wiebel/CANNode/Hardware/kicad/images/CANNode_rev2.0.jpg

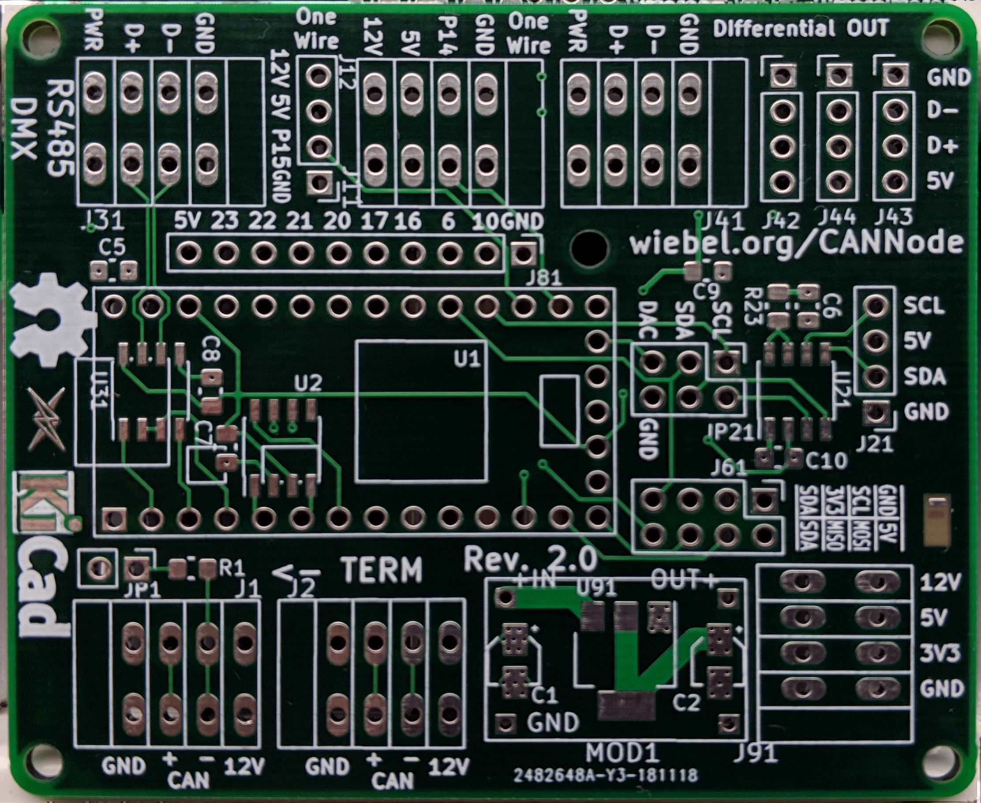
Hardware/kicad/images/CANNode_rev2.0.jpg
