wiebel/CANNode/Hardware/kicad/images/CANNode_rev2.5_top.png

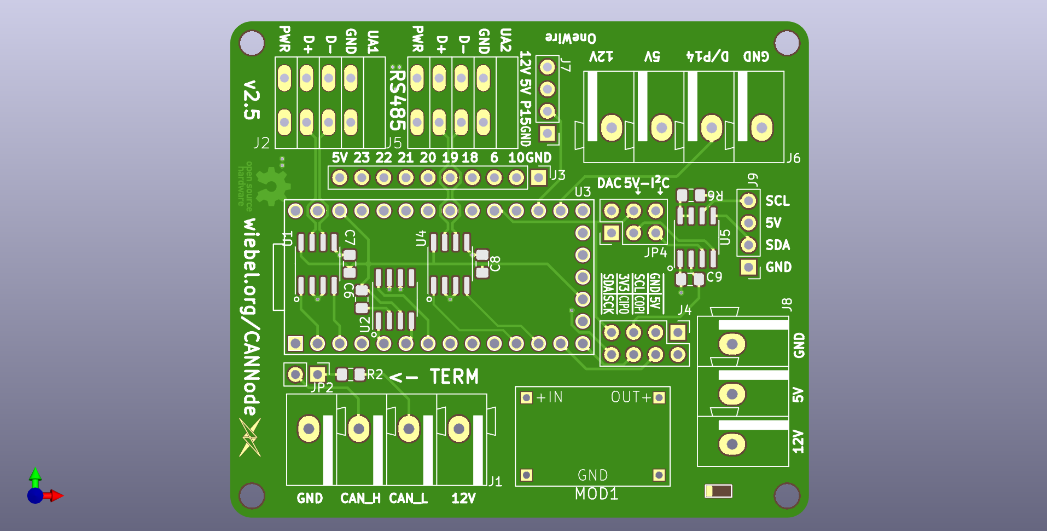
Hardware/kicad/images/CANNode_rev2.5_top.png
