wiebel/CANNode/README.md

Homegrown CAN/OW based home automation.

https://wiebel.org/CANNode/
