wiebel/CANNode/Hardware/eagle/CANNode_bottom.png

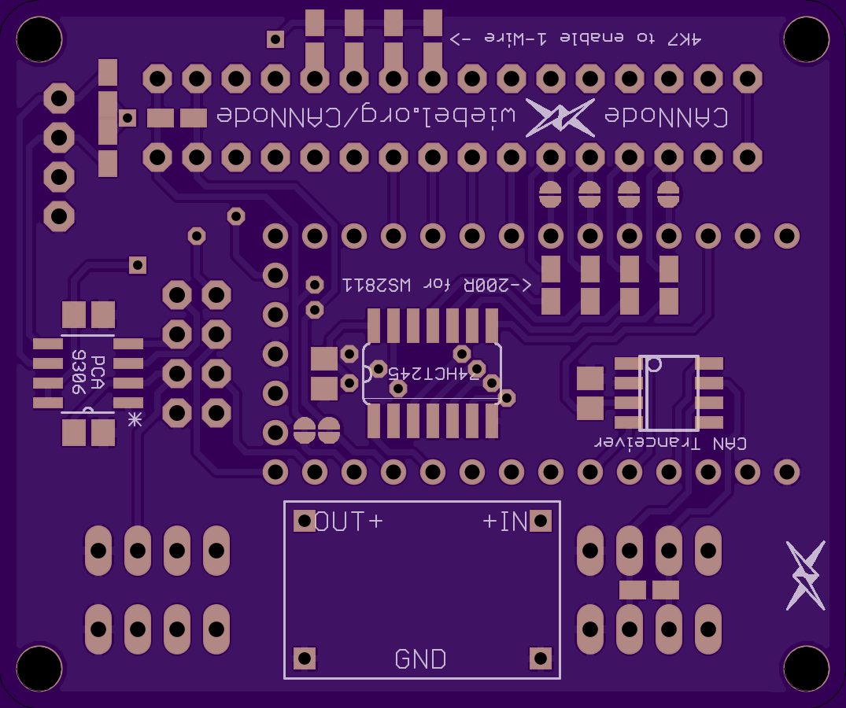
Hardware/eagle/CANNode_bottom.png
