wiebel/CANNode/Hardware/eagle/CANNode_r2_schematic.png

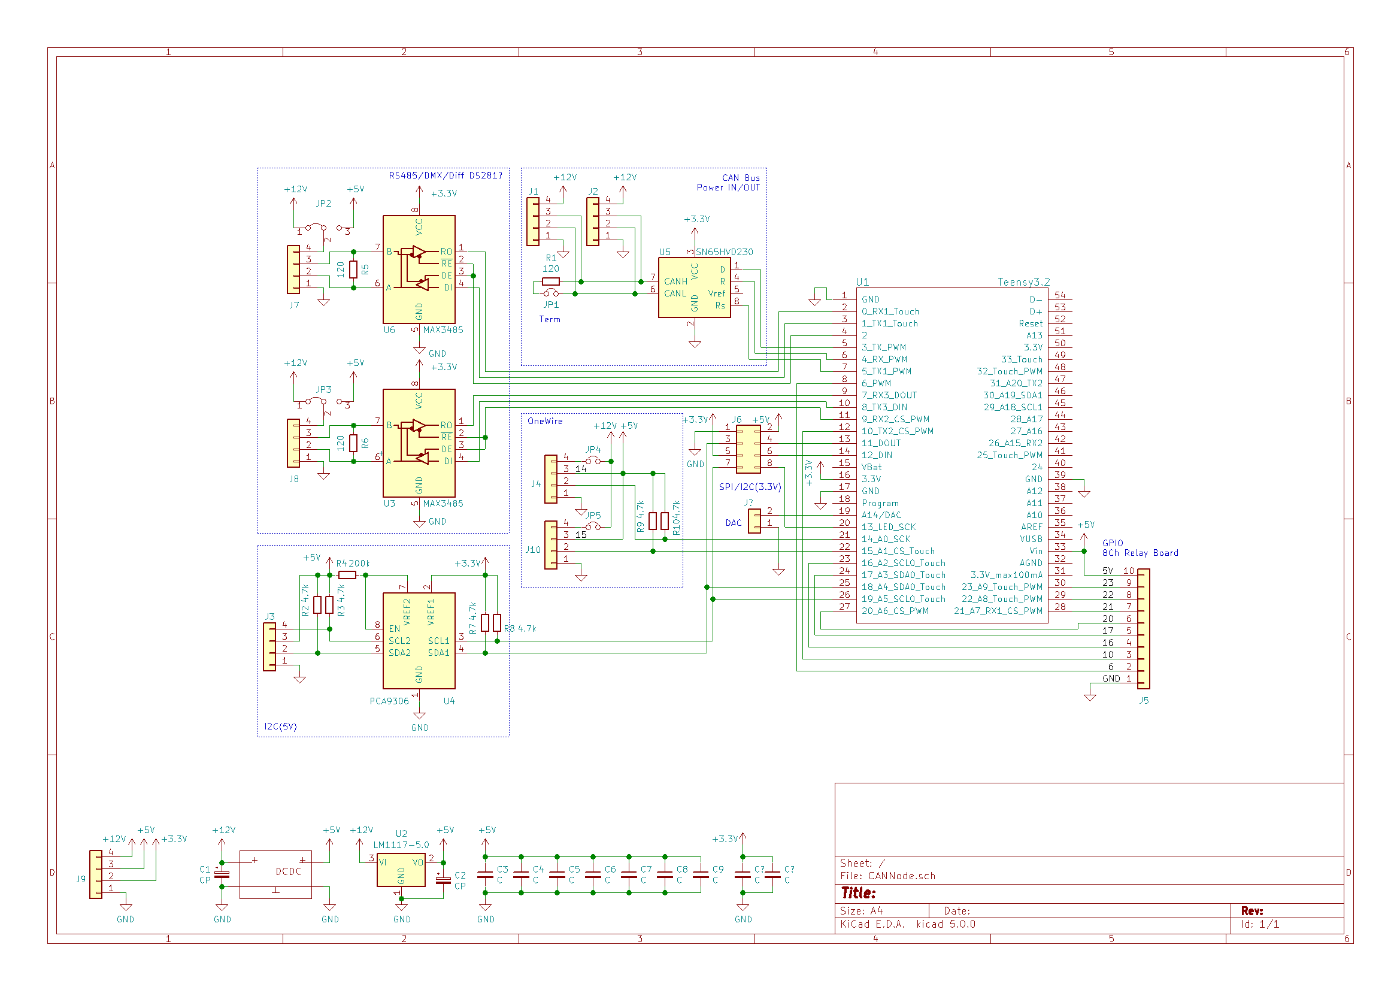
Hardware/eagle/CANNode_r2_schematic.png
