wiebel/CANNode/Hardware/eagle/CANNode_schematic.png

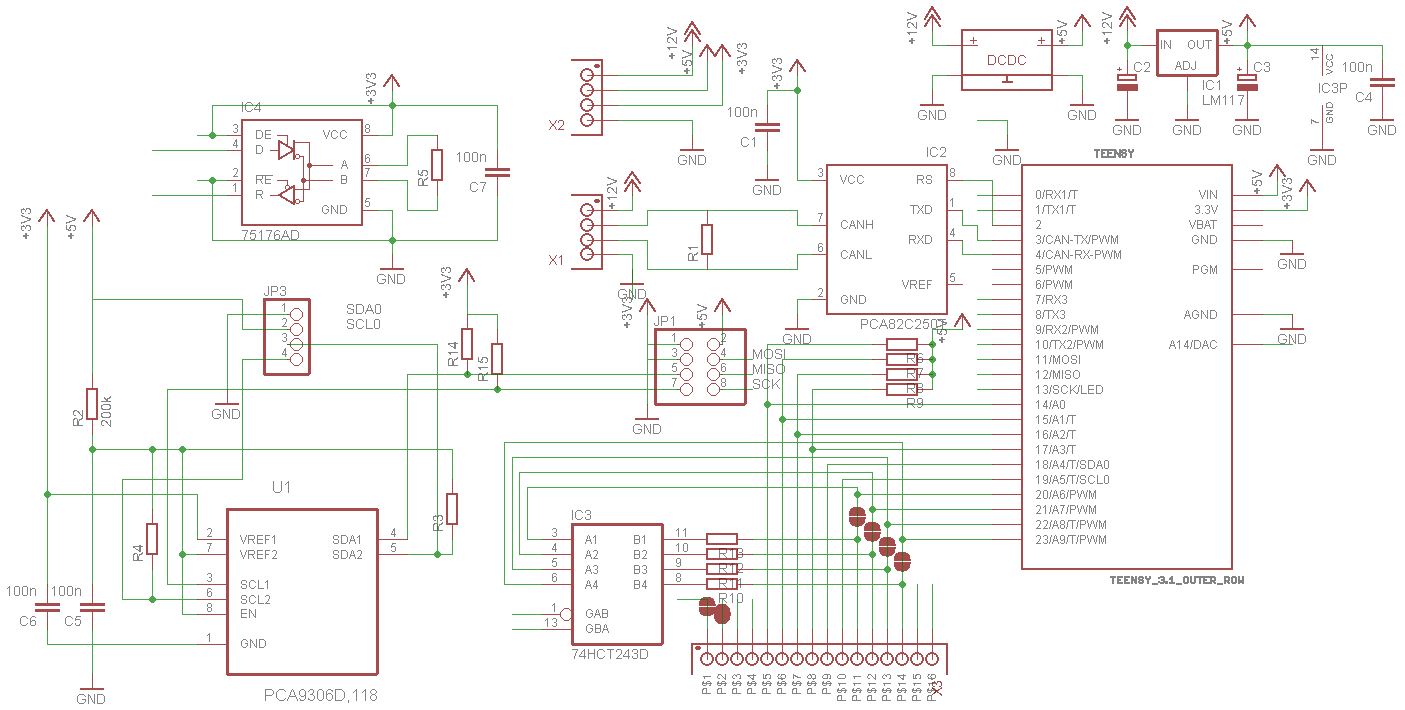
Hardware/eagle/CANNode_schematic.png
