wiebel/CANNode/Hardware/eagle/CANNode_top.png

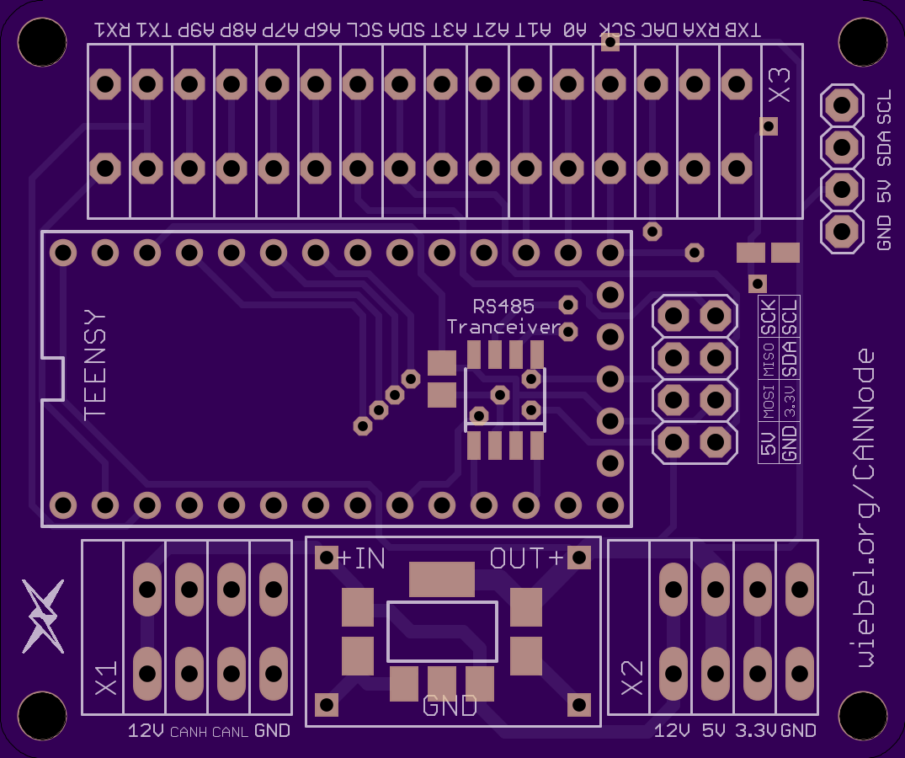
Hardware/eagle/CANNode_top.png
