wiebel/CANNode/Hardware/kicad/images/CANNode_rev2.0_jlcpcb_bottom.png

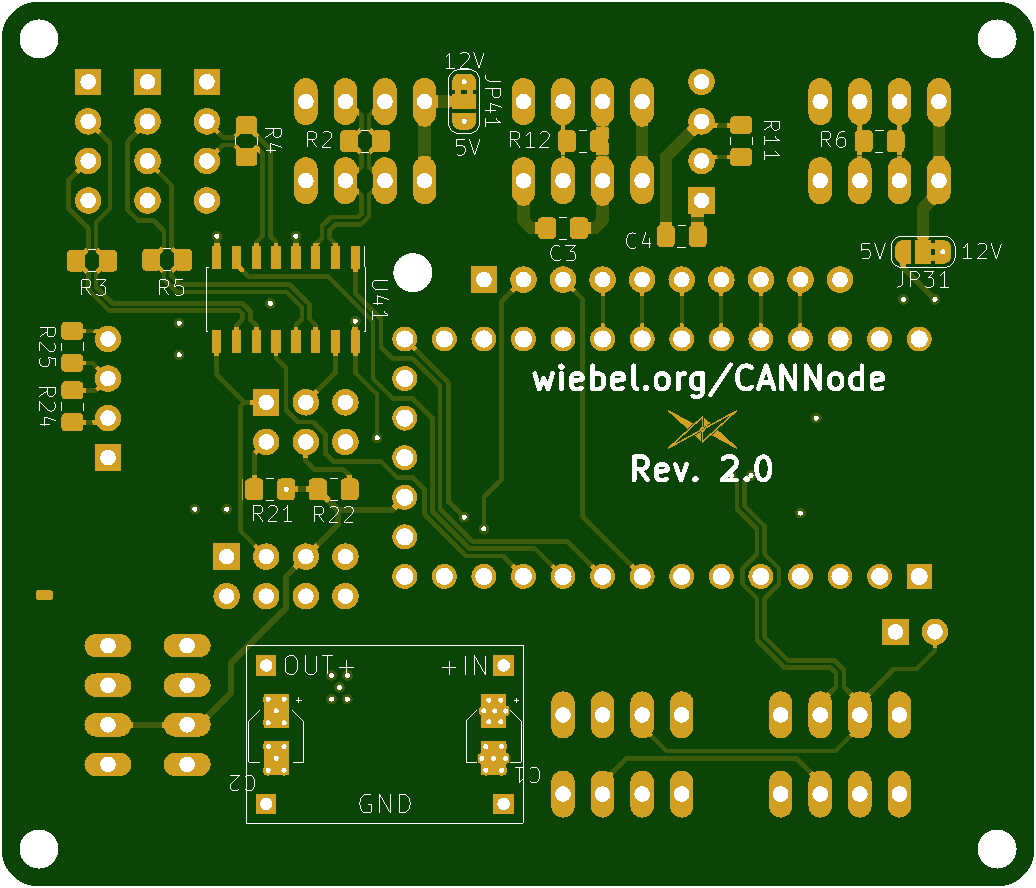
Hardware/kicad/images/CANNode_rev2.0_jlcpcb_bottom.png
