wiebel/CANNode/Hardware/kicad/images/CANNode_rev2.0_top.png

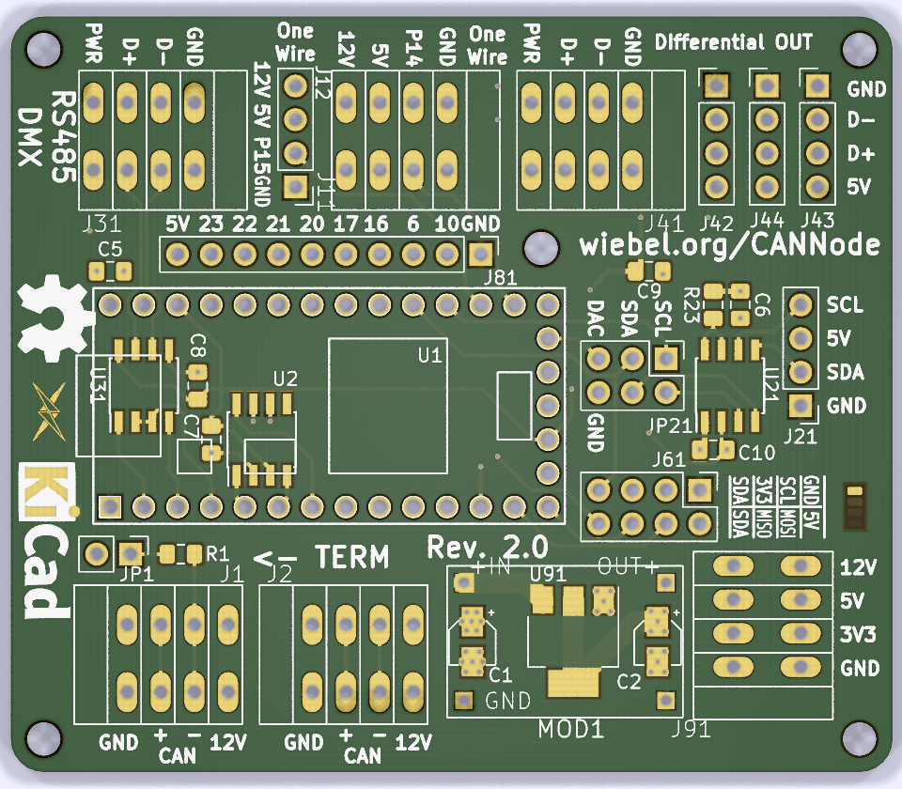
Hardware/kicad/images/CANNode_rev2.0_top.png
