wiebel/CANNode/Hardware/eagle/OW-sat/bom.csv

Designator | Manufacturer Part Number | Quantity
R1,R2 | RHA0J471MCN1GS | 2
IC1 | DS2406P+ | 1
