wiebel/CANNode/Hardware/kicad/images/CANNode_rev2.5.pdf

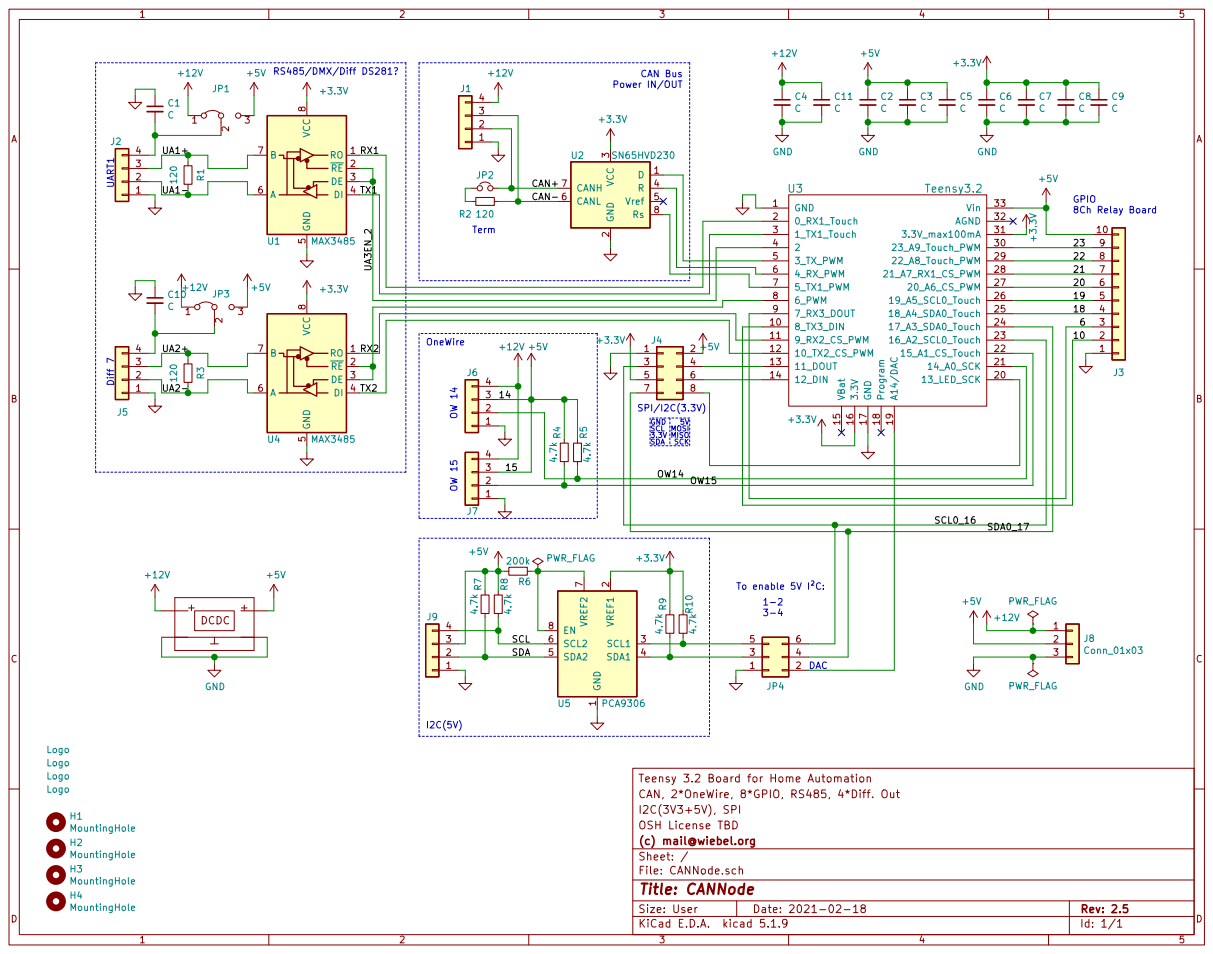
[picture p10: page 1]

3-4 To enable 5V I²C: SCK MISO MOSI 5V

SCL SDA

Teensy 3.2 Board for Home Automation
CAN, 2*OneWire, 8*GPIO, RS485, 4*Diff. Out
I2C(3V3+5V), SPI
File: CANNode.sch Sheet: / (c) mail@wiebel.org OSH License TBD
