wiebel/CANNode/Hardware/kicad/DiffWS2811/DiffWS2811.pdf

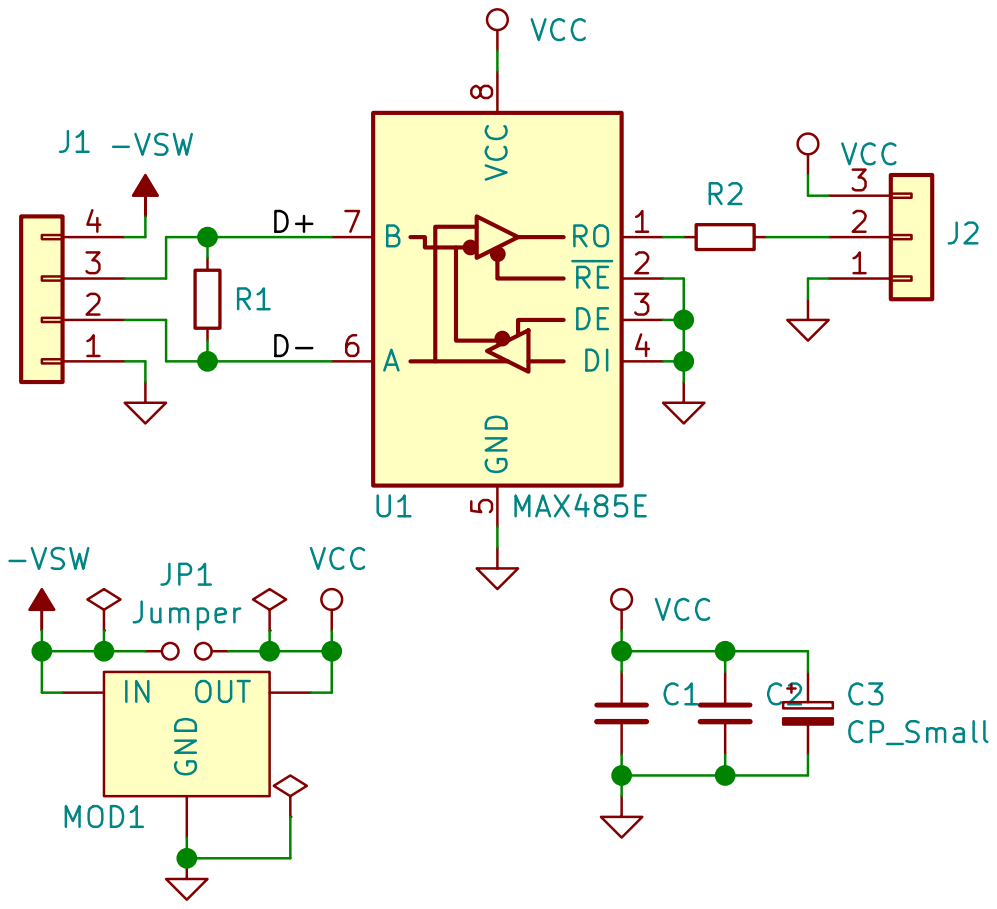
[picture p11: page 1]
