wiebel/CANNode/Hardware/kicad/CANNode.kicad_pcb

## KiCad design Hardware/kicad/CANNode.kicad_pcb (2021-02-18)

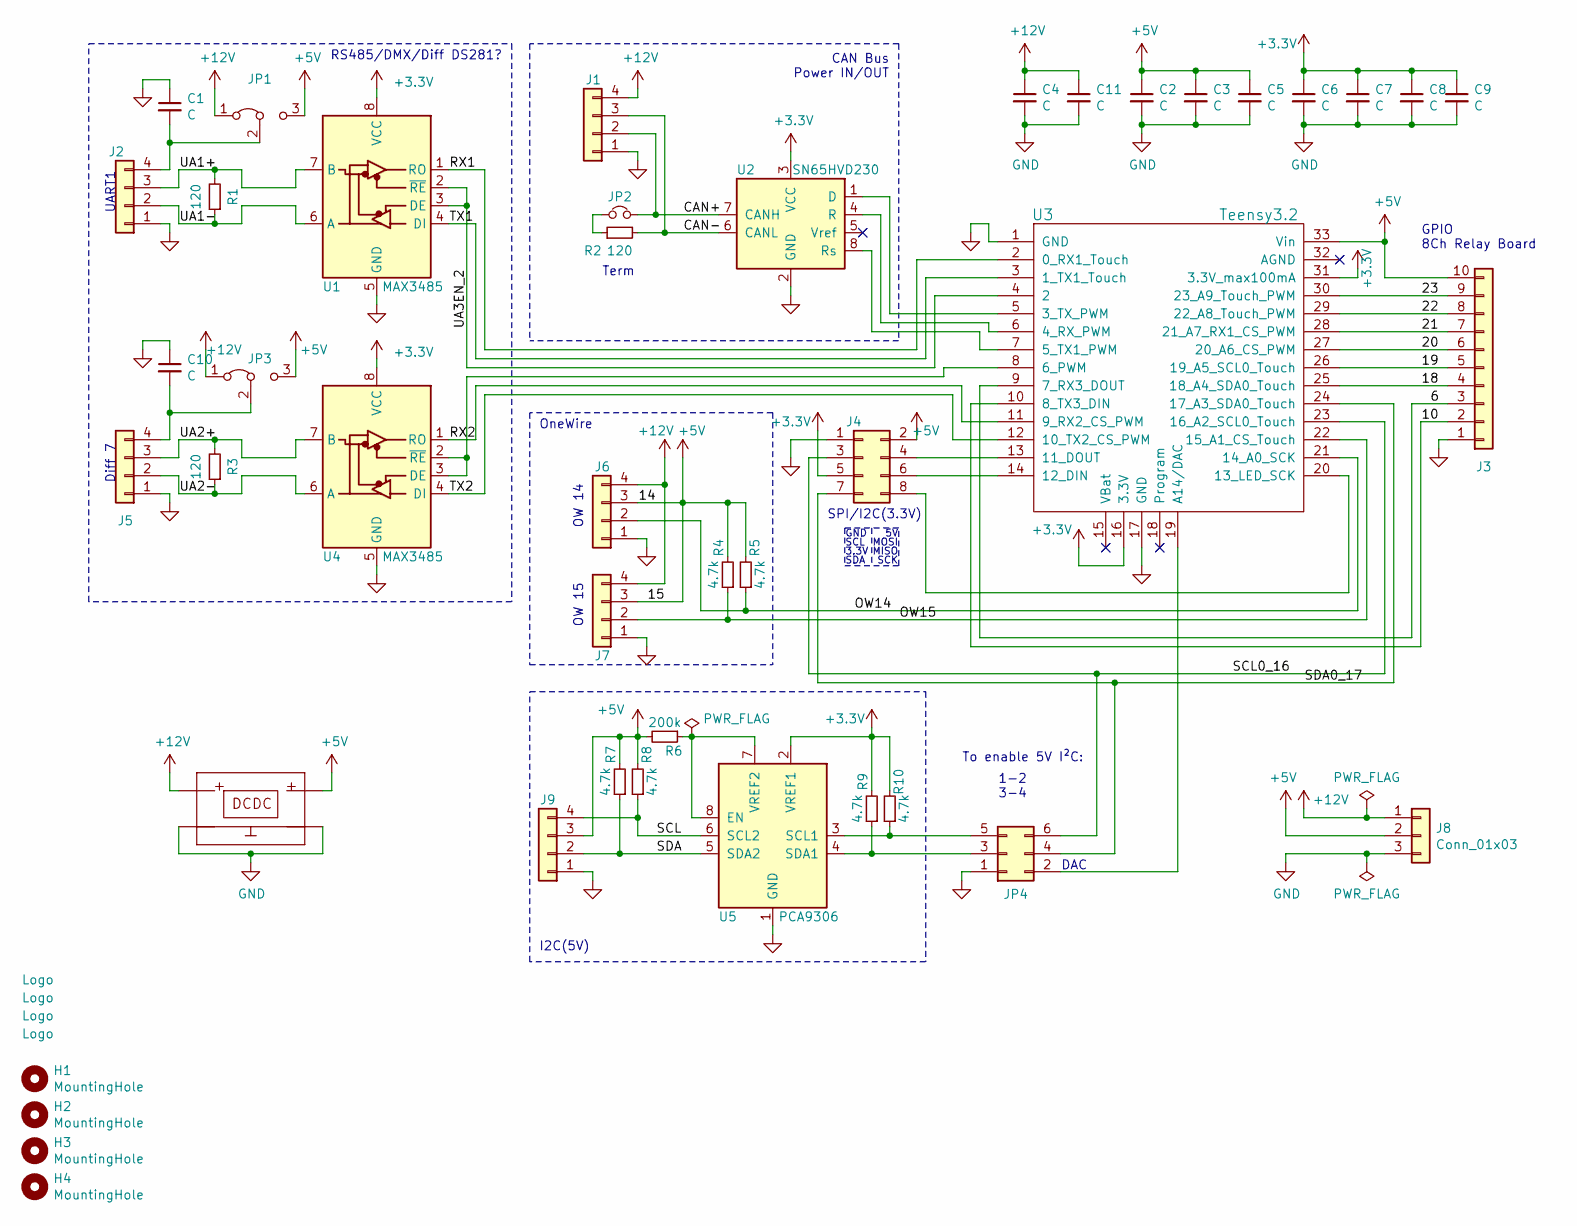
[picture p12: schematic CANNode.sch]

Parts:
C1, C2, C3, C4, C5, C6, C7, C8, C9, C10, C11: C; C_0805_2012Metric_Pad1.15x1.40mm_HandSolder
H1, H2, H3, H4: MountingHole; MountingHole_2.7mm
J1, J6: Conn_01x04; WAGO_243_4-Pole
J2, J5: Conn_01x04; OWN_KF141V-P4_simple
J3: Conn_01x10; PinHeader_1x10_P2.54mm_Vertical
J4: Conn_02x04_Odd_Even; PinHeader_2x04_P2.54mm_Vertical
J7, J9: Conn_01x04; PinHeader_1x04_P2.54mm_Vertical
J8: Conn_01x03; WAGO_243_3-Pole
JP1, JP3: Jumper_3_Bridged12; SolderJumper-3_P1.3mm_Bridged2Bar12_RoundedPad1.0x1.5mm_Num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
JP2: Jumper_NC_Small; PinHeader_1x02_P2.54mm_Vertical
JP4: Conn_02x03_Odd_Even; PinHeader_2x03_P2.54mm_Vertical
Log1, Log3: Logo; LOGO_MID
Log2, Log4: Logo; OSHW-Logo_5.7x6mm_Copper
MOD1: DSN-MINI-360; OWN_DC-DC
R1, R2, R3: 120; R_0805_2012Metric_Pad1.15x1.40mm_HandSolder
R4, R5, R7, R8, R9, R10: 4.7k; R_0805_2012Metric_Pad1.15x1.40mm_HandSolder
R6: 200k; R_0805_2012Metric_Pad1.15x1.40mm_HandSolder
U1, U4: MAX3485; SOIC-8_3.9x4.9mm_P1.27mm
U2: SN65HVD230; SOIC-8_3.9x4.9mm_P1.27mm
U3: Teensy3.2; Teensy3_min
U5: PCA9306; SOIC-8_3.9x4.9mm_P1.27mm

Connections:
+3V3: C6.1, C7.1, C8.1, C9.1, J4.5, R9.2, R10.2, U1.8 (VCC), U2.3 (VCC), U3.16 (3.3V), U3.31 (3.3V_max100mA), U4.8 (VCC), U5.2 (VREF1)
+5V: C2.1, C3.1, C5.1, J3.10, J4.2, J6.3, J7.3, J8.2, J9.3, JP1.3 (B), JP3.3 (B), MOD1.OUT+, R4.2, R5.2, R6.2, R7.2, R8.2, U3.33 (Vin)
+12V: C4.1, C11.1, J1.4, J6.4, J7.4, J8.1, JP1.1 (A), JP3.1 (A), MOD1.IN+
/6: J3.3, U3.9 (7_RX3_DOUT)
/10: J3.2, U3.10 (8_TX3_DIN)
/18: J3.4, U3.25 (18_A4_SDA0_Touch)
/19: J3.5, U3.26 (19_A5_SCL0_Touch)
/20: J3.6, U3.27 (20_A6_CS_PWM)
/21: J3.7, U3.28 (21_A7_RX1_CS_PWM)
/22: J3.8, U3.29 (22_A8_Touch_PWM)
/23: J3.9, U3.30 (23_A9_Touch_PWM)
/CAN+: J1.2, JP2.2, U2.7 (CANH)
/CAN-: J1.3, R2.2, U2.6 (CANL)
/OW14: J6.2, R5.1, U3.21 (14_A0_SCK)
/OW15: J7.2, R4.1, U3.22 (15_A1_CS_Touch)
/RX1: U1.1 (RO), U3.2 (0_RX1_Touch)
/RX2: U3.11 (9_RX2_CS_PWM), U4.1 (RO)
/SCL: J9.4, R8.1, U5.6 (SCL2)
/SCL0_16: J4.3, JP4.6, U3.23 (16_A2_SCL0_Touch)
/SDA: J9.2, R7.1, U5.5 (SDA2)
/SDA0_17: J4.7, JP4.4, U3.24 (17_A3_SDA0_Touch)
/TX1: U1.4 (DI), U3.3 (1_TX1_Touch)
/TX2: U3.12 (10_TX2_CS_PWM), U4.4 (DI)
/UA1+: J2.3, R1.2, U1.7 (B)
/UA1-: J2.2, R1.1, U1.6 (A)
/UA2+: J5.3, R3.2, U4.7 (B)
/UA2-: J5.2, R3.1, U4.6 (A)
/UA3EN_2: U1.2 (~RE), U1.3 (DE), U3.4 (2)
GND: C1.1, C2.2, C3.2, C4.2, C5.2, C6.2, C7.2, C8.2, C9.2, C10.1, C11.2, J1.1, J2.1, J3.1, J4.1, J5.1, J6.1, J7.1, J8.3, J9.1, JP4.1, MOD1.IN-, MOD1.OUT-, U1.5 (GND), U2.2 (GND), U3.1 (GND), U3.17 (GND), U4.5 (GND), U5.1 (GND)
unnamed: C1.2, J2.4, JP1.2 (C)
unnamed: C10.2, J5.4, JP3.2 (C)
unnamed: J4.4, U3.13 (11_DOUT)
unnamed: J4.6, U3.14 (12_DIN)
unnamed: J4.8, U3.20 (13_LED_SCK)
unnamed: JP2.1, R2.1
unnamed: JP4.2, U3.19 (A14/DAC)
unnamed: JP4.3, R9.1, U5.4 (SDA1)
unnamed: JP4.5, R10.1, U5.3 (SCL1)
unnamed: R6.1, U5.7 (VREF2), U5.8 (EN)
unnamed: U2.1 (D), U3.5 (3_TX_PWM)
unnamed: U2.4 (R), U3.6 (4_RX_PWM)
unnamed: U2.8 (Rs), U3.7 (5_TX1_PWM)
unnamed: U3.8 (6_PWM), U4.2 (~RE), U4.3 (DE)

Notes on the sheet:
CAN Bus Power IN/OUT
Term
RS485/DMX/Diff DS281?
OneWire
SPI/I2C(3.3V)
GPIO 8Ch Relay Board
DAC
I2C(5V)
Diff 7
UART1
OW 14
OW 15
GND
3.3V
SCL
SDA
MOSI
MISO
SCK
To enable 5V I²C:
1-2 3-4

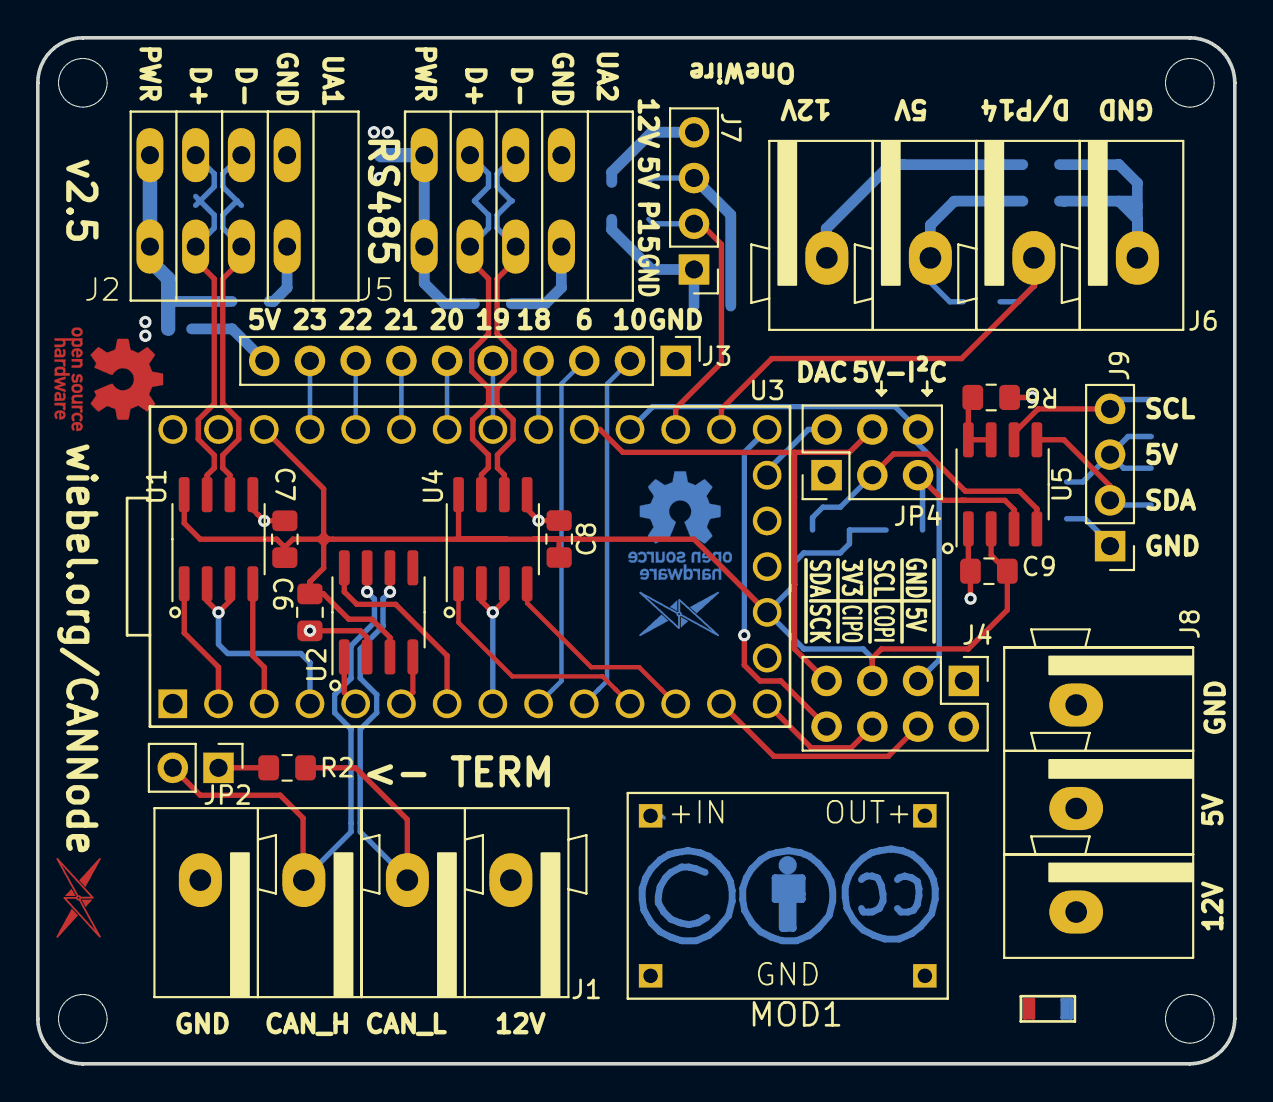
[picture p13: board CANNode.kicad_pcb from above]

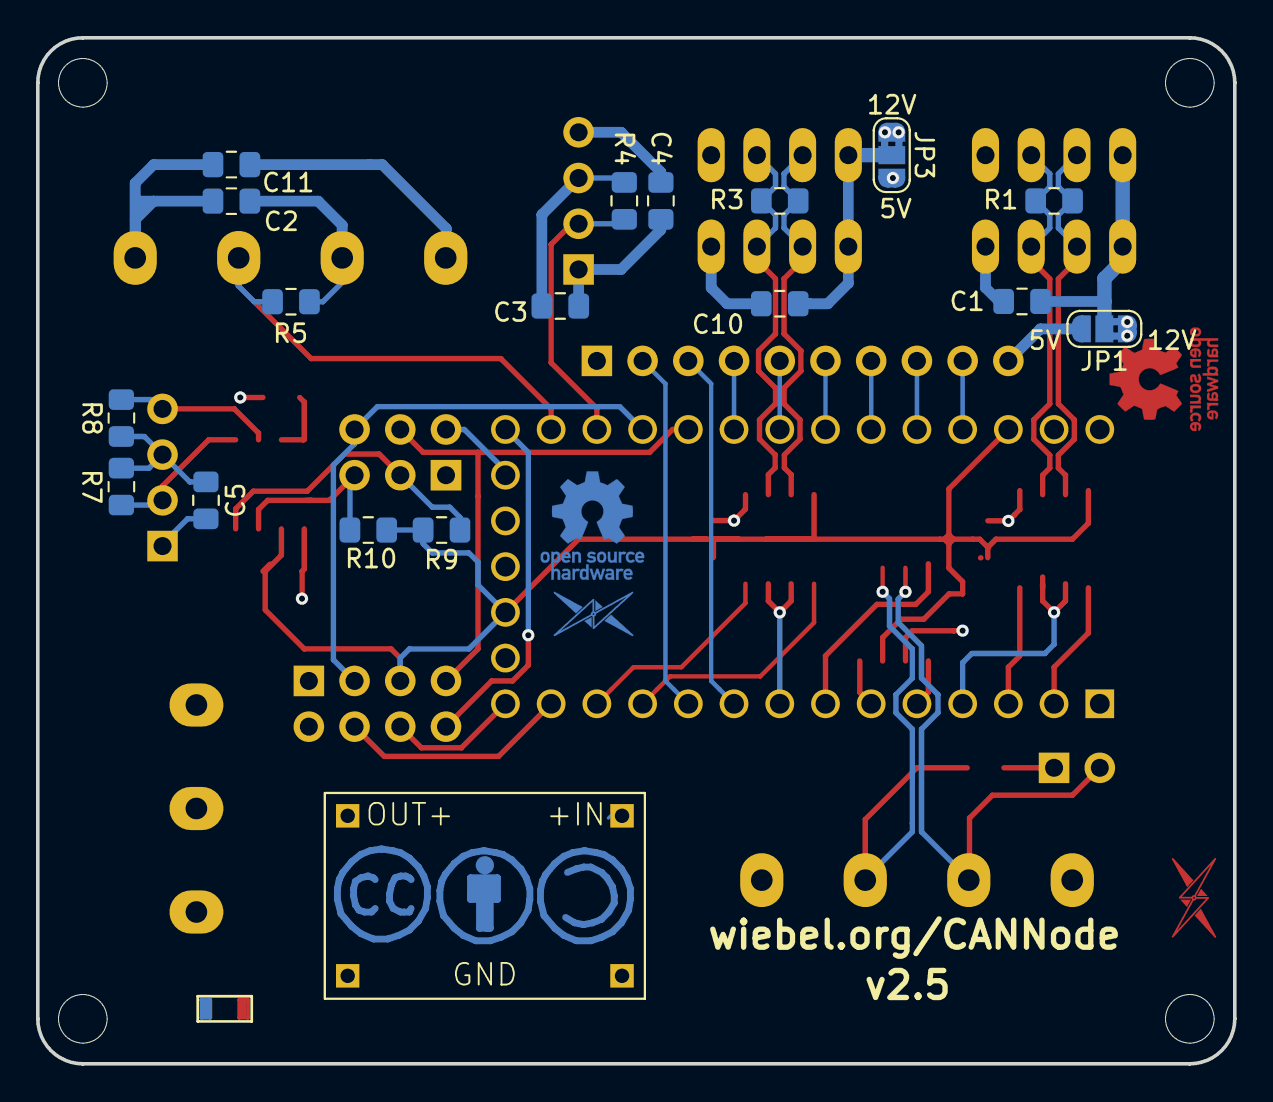
[picture p14: board CANNode.kicad_pcb from below]

Board: 4 copper layers, 66.5 x 57.0 mm, 48 parts (19 on the bottom side), 43 nets.
