wiebel/CANNode/Hardware/kicad/DiffWS2811/DiffWS2811.kicad_pcb

## KiCad design Hardware/kicad/DiffWS2811/DiffWS2811.kicad_pcb (2019-10-22)

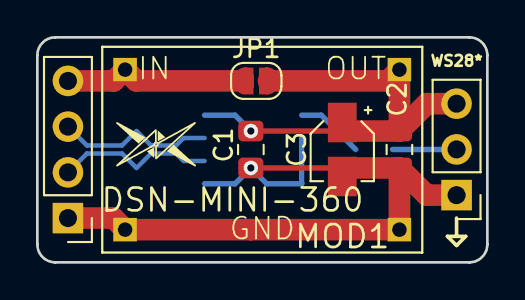
[picture p15: board DiffWS2811.kicad_pcb from above]

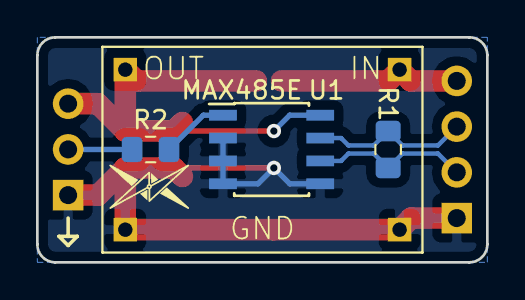
[picture p16: board DiffWS2811.kicad_pcb from below]

Board: 2 copper layers, 25.0 x 12.5 mm, 10 parts (3 on the bottom side), 7 nets.

Parts:
C1, C2: C_Small; C_0805_2012Metric_Pad1.15x1.40mm_HandSolder
C3: CP_Small; CP_Elec_3x5.4
J1: Conn_01x04; PinHeader_1x04_P2.54mm_Vertical
J2: Conn_01x03; PinHeader_1x03_P2.54mm_Vertical
JP1: Jumper; SolderJumper-2_P1.3mm_Open_RoundedPad1.0x1.5mm
MOD1: DSN-MINI-360; DC-DC
R1, R2: R_Small; R_0805_2012Metric_Pad1.15x1.40mm_HandSolder
U1: MAX485E; SOIC-8_3.9x4.9mm_P1.27mm

Connections:
-VSW: J1.4, JP1.1, MOD1.IN
/D+: J1.3, R1.1, U1.7
/D-: J1.2, R1.2, U1.6
GND: C1.2, C2.2, C3.2, J1.1, J2.1, MOD1.GND, U1.2, U1.3, U1.4, U1.5
unnamed: J2.2, R2.1
unnamed: R2.2, U1.1
VCC: C1.1, C2.1, C3.1, J2.3, JP1.2, MOD1.OUT, U1.8
