wiebel/CANNode/Hardware/eagle/CANNode.brd

## EAGLE design Hardware/eagle/CANNode.brd (2016-06-03)

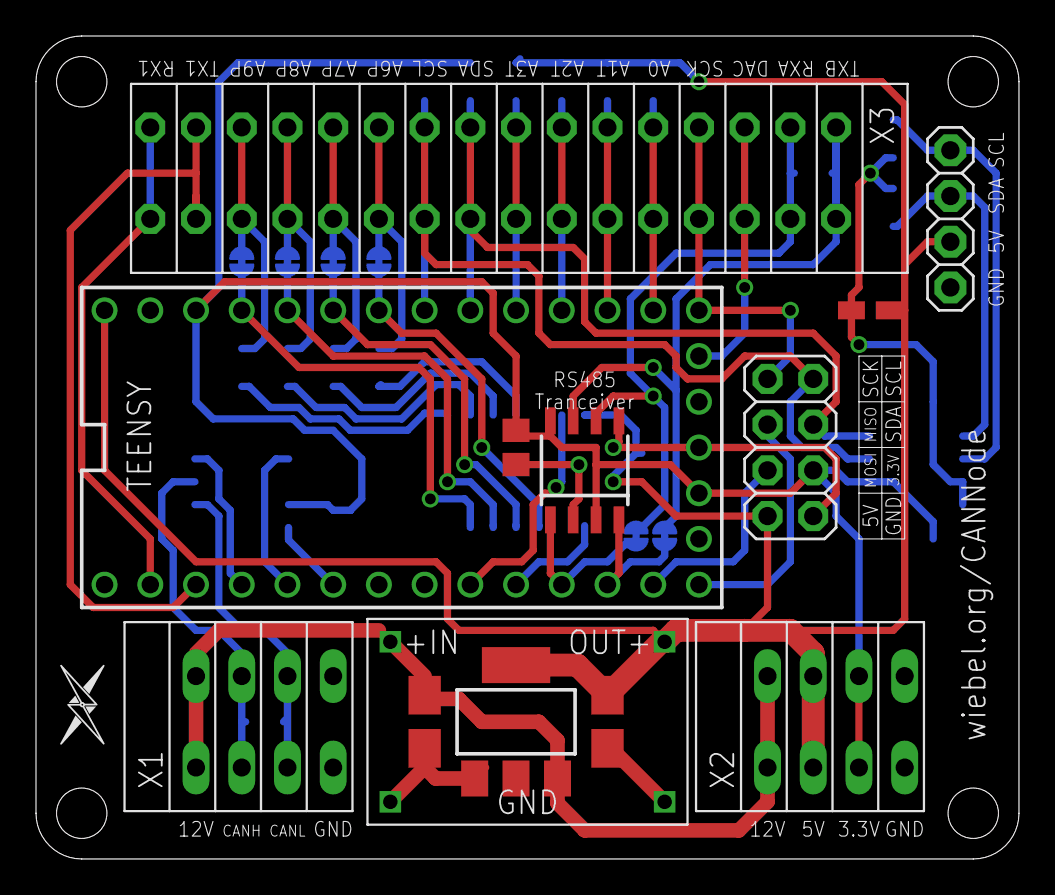
[picture p17: board CANNode.brd from above]

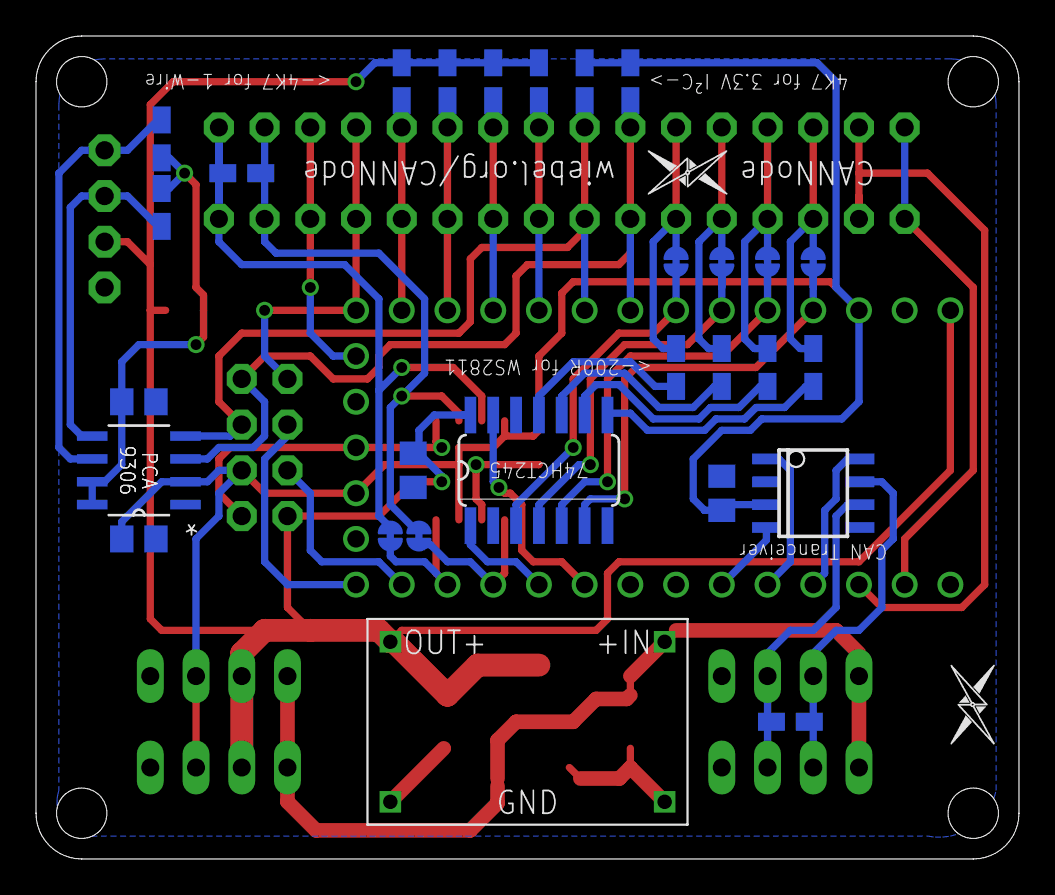
[picture p18: board CANNode.brd from below]

Board: 2 copper layers, 54.6 x 45.7 mm, 43 parts (29 on the bottom side), 38 nets.

Parts:
C1, C4, C5, C6, C7: 100n; C0805
C2, C3: A/3216-18W
IC1: LM117; SOT223
IC2: PCA82C250T; SO8
IC3: 74HCT243D; SO14
IC4: 75176AD; D_R-PDSO-G8
JP1: 2X04
JP3: 1X04
MOD1: DCDC; DC-DC
R1, R3, R4, R5, R6, R7, R8, R9, R10, R11, R12, R13, R14, R15: R0805W
R2: 200k; R0805W
TEENSY: TEENSY_3.1_OUTER_ROW; TEENSY3-OUTER_ROW
U1: PCA9306D,118; SOIC127P600X175-8N
U$1, U$6, U$7: LOGO_MID
U$2, U$3, U$4, U$5, U$14, U$15: 2-WAY_BRIDGE
X1, X2: KF141-P4; KF141V-P4
X3: KF141-P16; KF141V-P16

Connections:
+3V3: C1.2, C6.2, C7.2, IC2.3, IC4.3, IC4.8, JP1.3, R14.2, R15.2, TEENSY.3.3V, TEENSY.3.3V1, U1.2, X2.P$103, X2.P$203
+5V: C3.+, C4.2, IC1.4, IC3.14, JP1.2, JP3.2, MOD1.OUT+, R2.2, R6.1, R7.1, R8.1, R9.1, TEENSY.VIN, X2.P$102, X2.P$202
+12V: C2.+, IC1.3, MOD1.IN+, X1.P$101, X1.P$201, X2.P$101, X2.P$201
A14: TEENSY.RESET/DAC, X3.P$103, X3.P$203
GND: C1.1, C2.-, C3.-, C4.1, C5.1, C6.1, C7.1, IC1.1, IC2.2, IC3.7, IC4.2, IC4.5, JP1.1, JP3.1, MOD1.IN-, MOD1.OUT-, TEENSY.AGND, TEENSY.GND, TEENSY.GND1, U1.1, X1.P$104, X1.P$204, X2.P$104, X2.P$204
MISO: JP1.6, TEENSY.12
MOSI: JP1.4, TEENSY.11
unnamed: IC2.1, TEENSY.3
unnamed: IC2.4, TEENSY.4
unnamed: IC2.7, R1.2, X1.P$102, X1.P$202
unnamed: IC3.8, R10.2
unnamed: IC3.9, R11.2
unnamed: R12.1, U$3.B, X3.P$112, X3.P$212
unnamed: IC3.3, R13.1, TEENSY.20/A6, U$2.A, U$2.B, X3.P$111, X3.P$211
unnamed: IC3.10, R12.2
unnamed: IC2.8, TEENSY.2
unnamed: C5.2, R2.1, R3.2, R4.2, U1.7, U1.8
unnamed: R9.2, TEENSY.17/A3, X3.P$108, X3.P$208
unnamed: R8.2, TEENSY.16/A2, X3.P$107, X3.P$207
unnamed: R7.2, TEENSY.15/A1, X3.P$106, X3.P$206
unnamed: R6.2, TEENSY.14/A0, X3.P$105, X3.P$205
unnamed: R10.1, U$5.B, X3.P$114, X3.P$214
unnamed: IC3.5, R11.1, TEENSY.22/A8, U$4.A, U$4.B, X3.P$113, X3.P$213
unnamed: IC3.4, TEENSY.21/A7, U$3.A
unnamed: IC2.6, R1.1, X1.P$103, X1.P$203
unnamed: IC3.11, R13.2
unnamed: IC3.6, TEENSY.23/A9, U$5.A
RX1: TEENSY.0, X3.P$116, X3.P$216
RX2: IC4.1, IC4.6, R5.2, TEENSY.9, U$15.A, U$15.B, X3.P$102, X3.P$202
RX3: IC3.13, TEENSY.7
SCK: JP1.8, TEENSY.13, X3.P$104, X3.P$204
SCL0: JP1.7, R15.1, TEENSY.19/A5, U1.3, X3.P$110, X3.P$210
SCL_5V: JP3.4, R4.1, U1.6
SDA0: JP1.5, R14.1, TEENSY.18/A4, U1.4, X3.P$109, X3.P$209
SDA_5V: JP3.3, R3.1, U1.5
TX1: TEENSY.1, X3.P$115, X3.P$215
TX2: IC4.4, IC4.7, R5.1, TEENSY.10, U$14.A, U$14.B, X3.P$101, X3.P$201
TX3: IC3.1, TEENSY.8
