wiebel/CANNode/Hardware/eagle/OW-sat/sat_001.brd

## EAGLE design Hardware/eagle/OW-sat/sat_001.brd (2018-11-16)

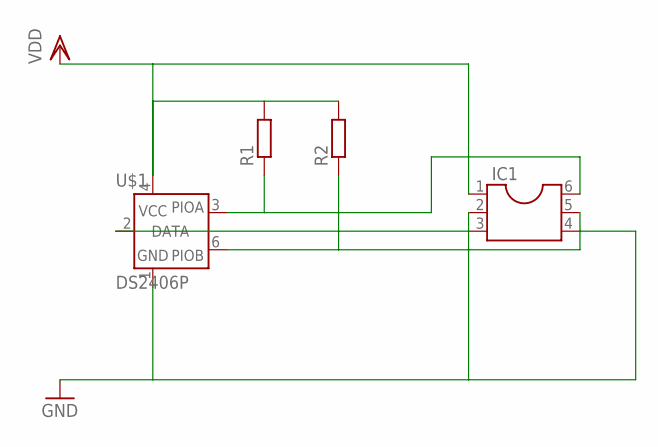
[picture p19: schematic sat_001.sch]

Parts:
IC1: DIL6; DIL06
R1, R2: R-EU_R0805; R0805
U$1: DS2406P; TSOC6

Connections:
GND: IC1.3, IC1.4, U$1.1 (GND)
unnamed: IC1.6, R1.1, U$1.3 (PIOA)
unnamed: IC1.5, R2.1, U$1.6 (PIOB)
unnamed: IC1.2, U$1.2 (DATA)
VDD: IC1.1, R1.2, R2.2, U$1.4 (VCC)

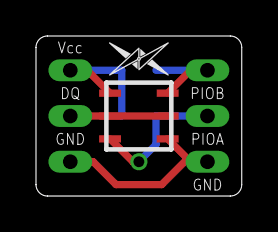
[picture p20: board sat_001.brd from above]

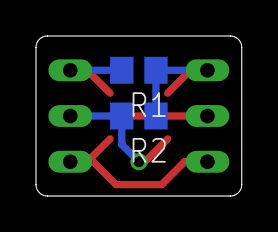
[picture p21: board sat_001.brd from below]

Board: 2 copper layers, 11.4 x 8.9 mm, 5 parts (2 on the bottom side), 5 nets.

Other parts of the board:
U$2: LOGO_SMAL
