wiebel/CANNode/src/Node_3_def.h

#include "CANNode.h"

// Node 03 - Keller
#define NODE_ID 0x03

// Misc

#define N_EVENTS 64 							// size of events array
#define N_SWITCHES 64 						// size of switch array
#define N_OUTPUTS 64
#define N_ACTIONS 64

#define DEBUG 0										// 1 for noisy serial
#define LED 13

#define RELAY1 0  // EZ 
#define RELAY2 1  // Küche
#define RELAY3 23 // Terrasse
#define RELAY4 22 // RO_Garten
#define RELAY5 17 // RO_Garten
#define RELAY6 16 // 
#define RELAY7 19 // EG Flur
#define RELAY8 18 //

// OneWire
#define OW_pin 14

// Definitions
static uint8_t node_id PROGMEM= { NODE_ID };
static OW_switch_t switches[N_SWITCHES] PROGMEM={
//  nick, addr[8], event_tag[pioA_FALL, pioA_RISE, pioB_FALL, pioB_RISE]
 { 11, { 0x12, 0xF2, 0x2A, 0x66, 0x0, 0x0, 0x0, 0x41 }, { 1, 1, 0, 0 } }, // EZ -> Flur
 { 12, { 0x12, 0x37, 0x8A, 0x4F, 0x0, 0x0, 0x0, 0xE5 }, { 2, 2, 2, 2 } }, // im keller TEST
 { 13, { 0x12, 0x71, 0x51, 0x57, 0x0, 0x0, 0x0, 0x28 }, { 2, 2, 0, 0 } }, // Küche  Kühlschank
 { 14, { 0x12, 0x5e, 0xff, 0x55, 0x0, 0x0, 0x0, 0x2c }, { 2, 2, 3, 3 } }, // Küche Terasse
 //{ 21, { 0x12, 0x86, 0xB4, 0x54, 0x0, 0x0, 0x0, 0x5F }, { 3, 3, 4, 4 } },
 { 22, { 0x12, 0x84, 0xAD, 0x4F, 0x0, 0x0, 0x0, 0x12 }, { 1, 1, 2, 2 } }, // EZ -> Küche
// { 31, { 0x12, 0x88, 0xDD, 0x53, 0x0, 0x0, 0x0, 0x28 }, { 210, 211, 220, 221 } }, // Rolladenschalter (A - UP, B - DOWN)
 { 31, { 0x12, 0x8F, 0xE2, 0x86 ,0x0, 0x0, 0x0, 0xC6}, { 220, 221, 210, 211 } }, // Rolladenschalter (A - UP, B - DOWN)
 { 0, { 0x0, 0x0, 0x0, 0x0, 0x0, 0x0, 0x0, 0x0 }, { 0, 0, 0, 0 } } // END MARK
};
static uint8_t switches_state[N_SWITCHES];
static outputs_t outputs[N_OUTPUTS] PROGMEM={
// type, address(PIN), initial value, inverted
  { GPIO, RELAY1, 0, true },
  { GPIO, RELAY2, 0, true },
  { GPIO, RELAY3, 0, true },
  { GPIO, RELAY4, 0, true },
  { GPIO, RELAY5, 0, true },
  { GPIO, RELAY6, 0, true },
  { GPIO, RELAY7, 0, true },
  { GPIO, RELAY8, 0, true },
  { NOP, 0xFF, 0, 0 }
};
static uint8_t outputs_state[N_OUTPUTS];
//  ID:
// 3 bit Prio, 2bit TYPE, 8bit DST, 8bit SRC, 8bit CMD/SEQ
// Type: 0: CMD, 1: FIRST, 2: CONT, 3: LAST
// CMD:
static event_t tx_events[N_EVENTS] PROGMEM={
// |    --- ID ---    |
// tag, prio, dst, cmd, data
{ 1, 0x03, 0x03, TOGGLE, 0x01},
{ 2, 0x03, 0x03, TOGGLE, 0x02},
{ 3, 0x03, 0x03, TOGGLE, 0x03},
{ 4, 0x03, 0x03, TOGGLE, 0x04},
{ 5, 0x03, 0x03, TOGGLE, 0x05},
{ 6, 0x03, 0x03, TOGGLE, 0x06},
{ 7, 0x03, 0x03, TOGGLE, 0x07},
{ 8, 0x03, 0x03, TOGGLE, 0x08},
{ 11, 0x03, 0x01, ON, 0x01},
{ 12, 0x03, 0x01, ON, 0x02},
{ 210, 0x03, 0x03, OFF, 0x04},
{ 211, 0x03, 0x03, ON, 0x04},
{ 220, 0x03, 0x03, OFF, 0x05},
{ 221, 0x03, 0x03, ON, 0x05},
{ 255, 0x03, 0xff, OFF, 0x09},
{ 254, 0x03, 0xff, ON, 0x09},
{ 10, 0x03, 0xff, TOGGLE, 0x01},
{ 10, 0x03, 0xff, TOGGLE, 0x02},
{ 10, 0x03, 0xff, TOGGLE, 0x03},
{ 10, 0x03, 0xff, TOGGLE, 0x04},
{ 10, 0x03, 0xff, TOGGLE, 0x05},
{ 10, 0x03, 0xff, TOGGLE, 0x06},
{ 10, 0x03, 0xff, TOGGLE, 0x07},
{ 10, 0x03, 0xff, TOGGLE, 0x08},

//  { 0x01, 0x0CFF0103, 1, { 0xDE, 0xAD } },
//  { 0x01, 0x0102DEAD, 2, { 0xDE, 0xAD } },
//  { 0x02, 0x0204BEEF, 4, { 0xDE, 0xAD, 0xBE, 0xEF } }
{ 0, 0, 0, 0, 0}
};

static action_t action_map[N_ACTIONS] PROGMEM={
//  tag, output_idx
  {1, 0}, // EZ
  {2, 1}, // Küche
  {3, 2}, // Terrasse
  {4, 3}, // RO_Garten 
  {5, 4}, // RO_Garten
  {6, 5},
  {7, 6}, // EG_Flur
  {8, 7},
  {9, 0},{9, 1},{9, 2},{9, 3},{9, 4},{9, 5},{9, 6},{9, 7},
  {210, 210},
  {211, 211},
  {220, 220},
  {221, 221},
};
