wiebel/CANNode/(commit log)

2016-06-03 renamed (see PCB)
2016-06-03 added Hardware sources
    [CANNode.brd, CANNode.sch]
2016-06-03 Added Schematic as png
2016-06-11 now with response and remote switching
2016-09-18 kinda working, still queing problems
    [CANNode.cpp]
2016-09-18 first Switches
2016-09-27 better initialization, consistant switches
2017-01-15 new external node definition
    [CANNode.sch]
2017-02-15 improved error handling of OW devices
    [CANNode.cpp, Node_3_def.h]
2017-03-22 Revert "mirror test"
    This reverts commit f052826ef3645006a35cdb1b423a686126aebfa9.
    [CANNode.h]
2017-10-02 Revert "new node and FastLED"
    This reverts commit 4730087f9e0407dac3795dfea3b10a3f22bc8b54.
    [CANNode.cpp, CANNode.h, Node_2_def.h, Node_3_def.h]
2017-10-05 Revert "latest addition (rolladen, Terasse)"
    This reverts commit 26ac6558e48cb40bebec67ddc240ef2eee2f421f.
    [CANNode.cpp, Node_3_def.h]
2017-10-05 Revert "git test"
    This reverts commit f4ac188a96c213f6665db2e03689f4f45f09be38.
    [CANNode.cpp]
2018-01-19 Latest addition WZ switch
2018-11-12 rev2 started on kicad
    [CANNode.kicad_pcb, CANNode.sch]
2018-11-13 kicad 101
    [CANNode.kicad_pcb, CANNode.sch]
2018-11-16 almost routed
    [CANNode.brd, CANNode.kicad_pcb, CANNode.sch, bom.csv, sat_001.brd, sat_001.sch]
2018-11-17 looks good
    [CANNode.kicad_pcb]
2018-11-17 late changes
    [CANNode.kicad_pcb, CANNode.sch]
2018-11-22 more clearance in Layer 2
    [CANNode.kicad_pcb, CANNode.sch]
2018-11-22 cleanup after order
    [CANNode.kicad_pcb, CANNode.sch]
2018-11-22 corrected output port labels
    [CANNode.kicad_pcb, CANNode.sch]
2018-12-03 ena I²C text
    [CANNode.kicad_pcb, CANNode.sch]
2019-03-17 new switch in WZ
    [CANNode.kicad_pcb]
2019-04-02 much better can bus writing
2019-09-02 last before adding current sensors
2019-10-22 new images (pdf)
    [CANNode.sch, DiffWS2811.kicad_pcb, DiffWS2811.sch, DiffWS2811_min.kicad_pcb]
2019-11-16 double RS485
    [CANNode.sch]
2019-11-16 second RS485 swapped with OW
    [CANNode.kicad_pcb, CANNode.sch]
2019-12-16 fixed loop for shutter2can
    [shutter2can.py]
2020-01-15 try for command to fix failure in unknowtry for command to fix failure in unknownn
    [mqtt2can.py]
2020-02-25 latest additions
    [CANNode.kicad_pcb]
2020-07-01 pproaching v2.5
    [CANNode.kicad_pcb, CANNode.sch]
2021-02-18 PCB fixed silkscreen
    [CANNode.kicad_pcb, CANNode.sch]
